Jupsi/logi_z906_wifi/README.md

# Logitech Z906 WiFi Home Assistant Mod with Console Integration

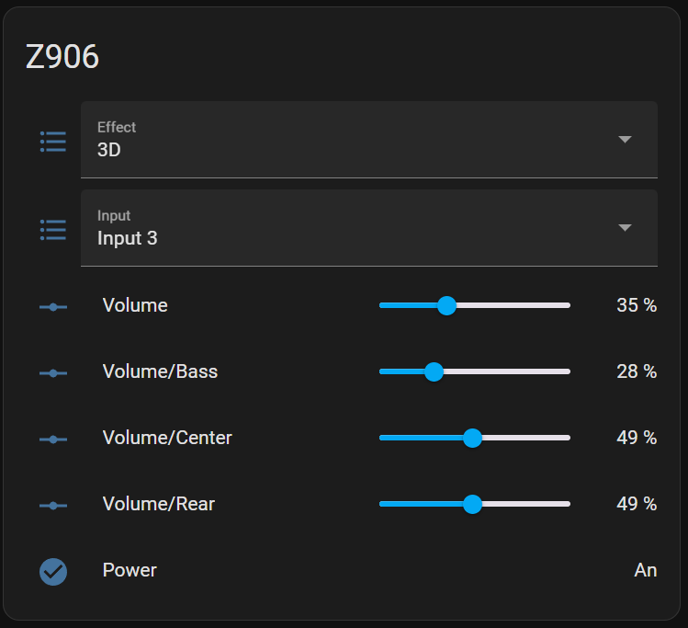
[picture p1: images/haos.png]
Z906 WiFi Mod


This project provides a way to control your Logitech Z906 speaker system via WiFi using an ESP32 microcontroller. It includes MQTT integration for seamless control and automatic integration with Home Assistant.

I am aware that there are already multiple projects for this Sound System, but none of them integrated the original Z906 Console.
With this Project you can still use your Console for the System.

This project is perfect for everybody who's IR Receiver stopped working (like mine).

## Features

- Control volume, input, effects, and individual levels of the Z906 system
- Visual Power on/off the Z906 system (Sensor)
- Home Assistant integration using MQTT and auto-discovery
- Keep the Z906 Console functional instead of replacing it
- Visual Feedback for all MQTT-Commands on the Console

## Hardware Requirements

- ESP32 microcontroller
- Logitech Z906 speaker system
- WiFi network
- DE-15 (VGA) Female Breakout Board
- DE-15 (VGA) Male Breakout Board
- (Optional) ESP32 Breakout Board

## Software Requirements

- Arduino IDE
- ESP32 board support for Arduino IDE
- Home Assistant
- Mosquitto MQTT broker

## Installation

1. **Clone this repository:**
   ```sh
   git clone https://github.com/Jupsi/logi_z906_wifi.git
   cd logi_z906_wifi/sketch_jun7a
   ```
2. **Install the necessary libraries in the Arduino IDE:**
   - PubSubClient
   - ArduinoJson

3. **Open the project in Arduino IDE:**
   - Open `sketch_jun7a.ino` in Arduino IDE.

4. **Update WiFi and MQTT settings:**
   - In `WifiSetup.cpp`, update your WiFi credentials.
   - In `sketch_jun7a.ino`, update your MQTT broker credentials in the setup method.

5. **Flash the ESP32:**
   - Connect your ESP32 to the computer.
   - Select the correct board and port in the Arduino IDE.
   - Click "Upload" to flash the ESP32.

6. **Configure Home Assistant:**
   - Ensure Mosquitto broker is installed and running in Home Assistant.
   - The auto-discovery feature should automatically add the Z906 entities to Home Assistant.

## Cable Connections

Below is a table showing all cable connections between the Console, Amplifier, and ESP32:

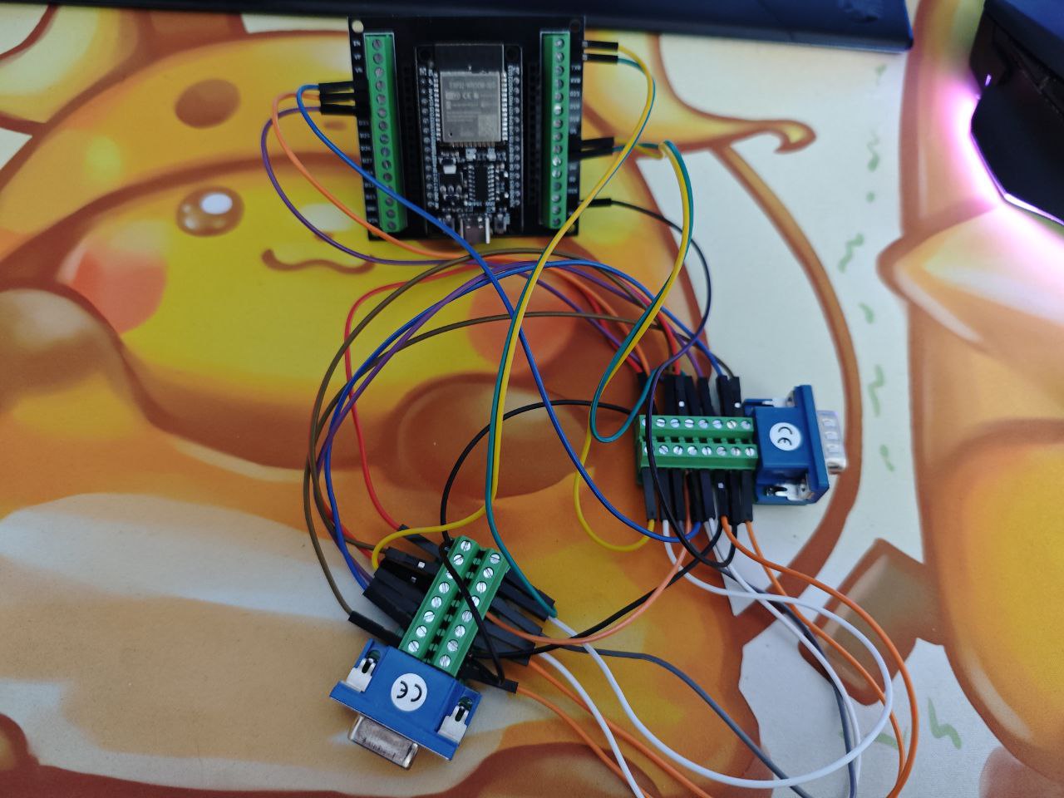
[picture p2: images/alle.jpg]
Cable Connections

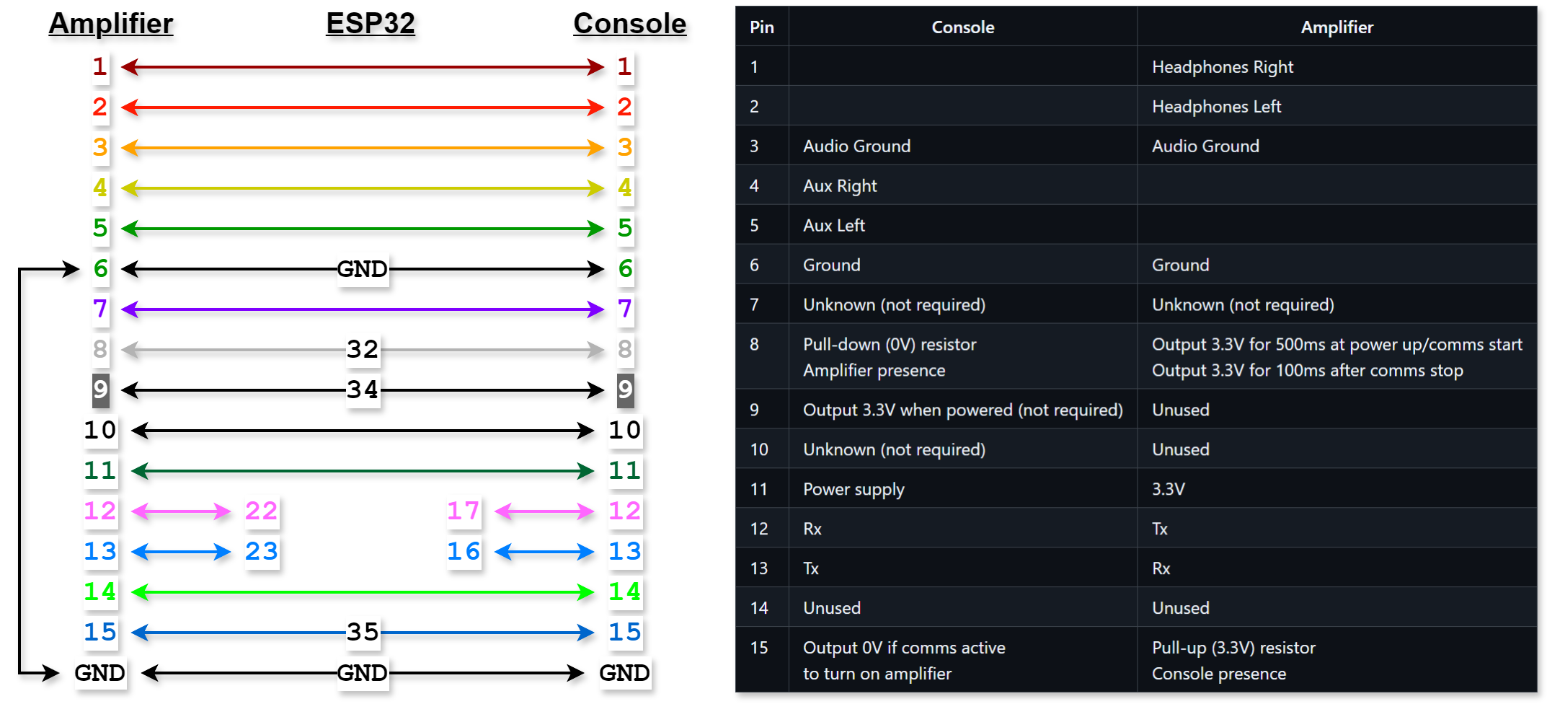
[picture p3: images/diagram.png]
Diagram


| Amplifier | Console | ESP32  |
|---|---|---|
| 1 | 1 | X |
| 2 | 2 | X |
| 3 | 3 | X |
| 4 | 4 | X |
| 5 | 5 | X |
| 6 + GND | 6 | GND |
| 7 | 7 | X |
| 8 | 8 | 32 |
| 9 | 9 | 34 |
| 10 | 10 | X |
| 11 | 11 | X |
| X | 12 | 17 |
| X | 13 | 16 |
| 12 | X | 22 |
| 13 | X | 23 |
| 14 | 14 | X |
| 15 | 15 | 35 |
| GND | GND | GND |

You can adjust all ESP32 Headers in the z906.h file.
```
//esp GPIO Header
  const int ADC_PIN_LOW = 35;
  const int ADC_PIN_CON_BOOT = 32;
  const int ADC_PIN_CABLE_CONNECTED = 34;
  const int8_t RX_CONSOLE_GPIO = 16;
  const int8_t TX_CONSOLE_GPIO = 17;
  const int8_t RX_AMP_GPIO = 22;
  const int8_t TX_AMP_GPIO = 23;
```

## Known Issues
- When restarting the console with the dedicated power button some garbage data will arrive on the serial lines. This confuses the console and you'll have to un- and replug it. I tried to fix that by integrated Pin 15 and Pin 8 but its not working properly.
- Mute is mostly tracked by the console so I could not integrate it into Home Assistant and provide full functionality.

## Troubleshooting
- Console is switching Inputs and/or Effect on its own
    1. Switch the Console off with the dedicated Power button.
    2. Wait atleast 5 seconds to assure the Console shuts down completely.
    3. Press Input for 8 Seconds and wait for 4 Input lights to light up.
    4. Console config is reset to default.
    5. Sometimes this needs to be done without the ESP32 in place.

- Console won't start
    1. Unplug the Console from ESP32.
    2. Restart ESP32.
    3. Wait ~10 seconds for ESP32 to startet completely.
    4. Replug the Console.

- Console auto shuts off
    1. Turn on the Console.
    2. Press Level for 5 Seconds until the Level lights shut off.
 
- Console shows 3 LEDs (no Serial Signal)
     1. Plug off Console
     2. Restart ESP
     3. Wait for ESP to fully Boot
     4. Plug in Console
 
None of the above problems appear when auto shutdown is turned off and the console is powered off while connecting everything together.

All of the problems are due to the Fact I could not figure out how to correctly use Pin 8 and Pin 15 since there is no real documentation about them. 
Maybe someone will figure it out.

## License
This project is licensed under the GNU General Public License v3.0 (GPL-3.0). You are free to use, modify, and distribute the code, provided it is not for commercial purposes.

## Contribution
Contributions are welcome! Please open an issue or submit a pull request if you have any improvements or bug fixes.

## Support
For any questions or support, please open an issue in this repository.

## Special Thanks
- https://github.com/nomis for reverse Engineering this System
