Jupsi/logi_z906_wifi/images/connectors.jpg

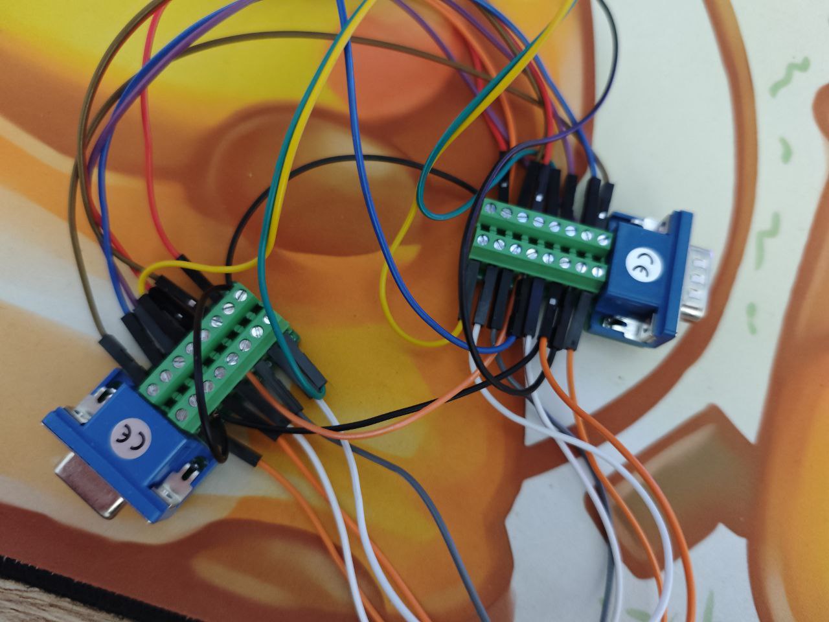
images/connectors.jpg
