Jupsi/logi_z906_wifi/images/daisychain.jpg

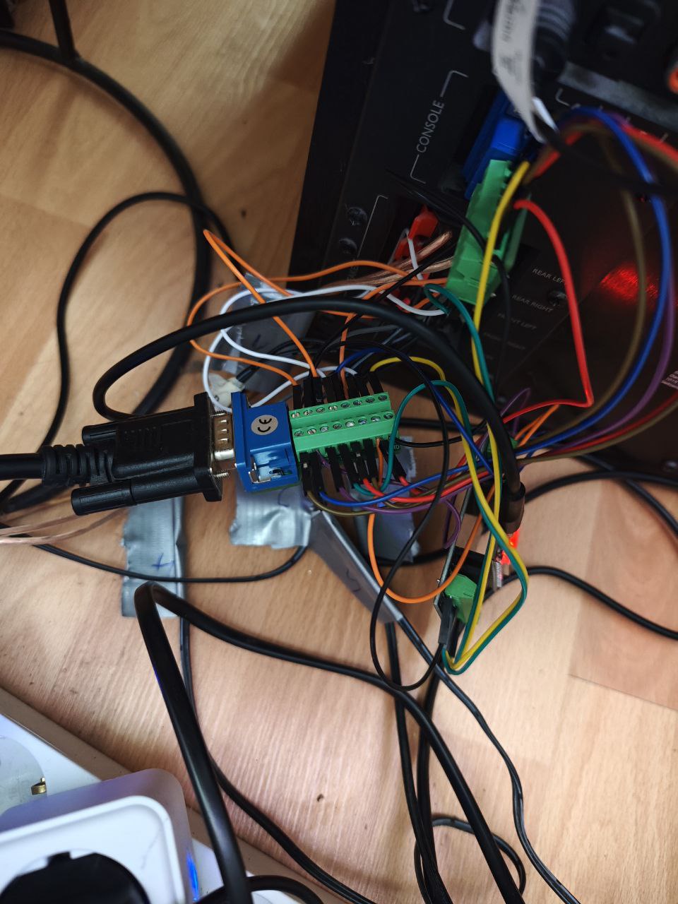
images/daisychain.jpg
