Jupsi/logi_z906_wifi/images/esp.jpg

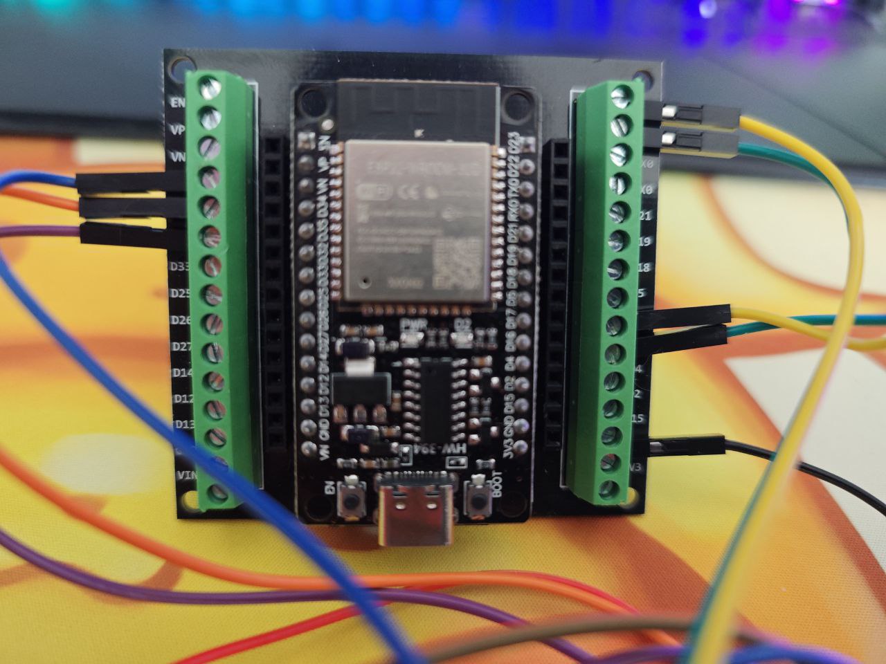
images/esp.jpg
