Jupsi/logi_z906_wifi/images/kabel.png

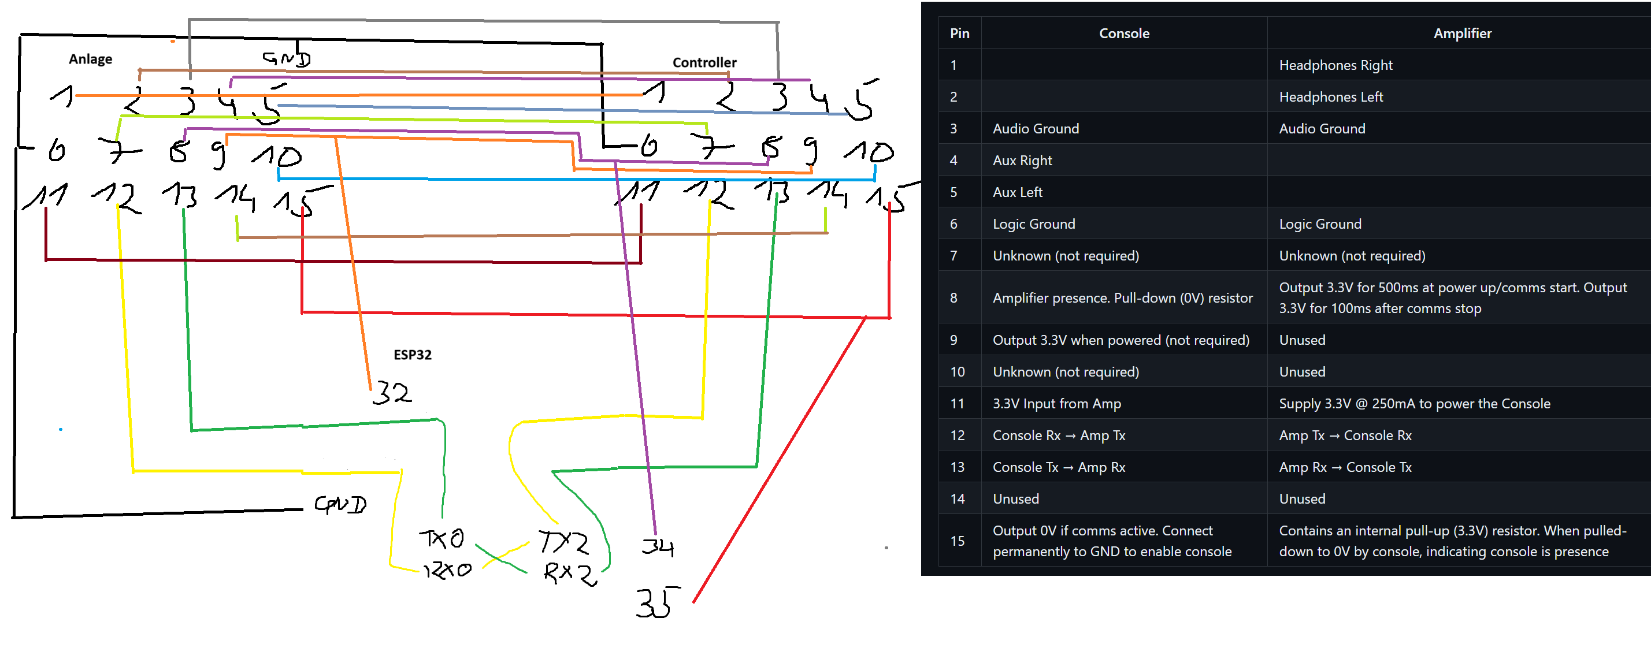
images/kabel.png
