Jupsi/logi_z906_wifi/(threads)

Thread 1 (2024-08-09):

An Other Build ?

anhnvme, 2024-08-09:
Hello,
Fist all, thank you for creating this project

I see this guy and his project look like simple https://github.com/LewisSmallwood/IoT-Logitech-Z906
Just once  Male DE-15 instead 2 cable like you

I think you can look into this project then convert to MQTT ?

Jupsi, 2024-08-10:
Hi, my Project was specially ment to be 2 Cables because i wanted to intergrate the z906 Console.

I do not understand what issue you want to report with this.
Kind regards

Closed 2024-08-27.

Thread 3 (2024-09-13):

Rear Volume controls work for volume down, but not volume up

EpicLPer, 2024-09-13:
Heya,

I think there's a bug (or at least on my Z906) where adjusting the rear speaker volume down in Home Assistant works just fine, as example setting it from 100% to 60% works as expected.
However trying to set the volume back up results in the volume stepping down further, as example adjusting back from 60% to 100% results in the Z906 setting the rear speakers to 21% for whatever reason :) Trying to set them again to 100% just turns it to 0% entirely then.

When adjusting the volume back to 100% via the remote updates the value on Home Assistant as normal again.

Might be a bug where the volume up serial communication was accidentally flipped around and it's sending a volume down command instead?

Thanks already for your work here, I've been waiting for years for someone to realize a project like this! ❤️

Jupsi, 2024-09-13:
Yes the bug is known and i will fix it as soon i have spare time.
For a quick self fix
go to z906_onmqttmessage.cpp
and adjust the code like this
void Z906::_OnMQTTMessage_SetVolume_Rear(MQTT* mqttClient, const char* message) {
  //Rear Volume Broker Message Handle
  auto volume = Z906::_Helper_ConvertPercentToVolume(atoi(message));

  if (volume > _volume_rear) {
    while (volume > _volume_rear) {
      volume--;
      serialAmp->write(static_cast<uint8_t>(SERIAL_HEADER::RESET_IDLE_TIME));
      serialAmp->write(static_cast<uint8_t>(SERIAL_HEADER::VOLUME_REAR_UP));
      serialAmp->write(static_cast<uint8_t>(SERIAL_HEADER::RESET_IDLE_TIME));
    }
  } else {
    while (volume < _volume_rear) {
      volume++;
      serialAmp->write(static_cast<uint8_t>(SERIAL_HEADER::RESET_IDLE_TIME));
      serialAmp->write(static_cast<uint8_t>(SERIAL_HEADER::VOLUME_REAR_DOWN));
      serialAmp->write(static_cast<uint8_t>(SERIAL_HEADER::RESET_IDLE_TIME));
    }
  }
  Serial.print("Rear Volume Set to: ");
  Serial.println(volume);
}

EpicLPer, 2024-09-13:
Thanks, will try!

Bit offtopic but do you by any chance plan to port this to ESPHome as an official integration at some point? Might also be easier for firmware updates or trying to debug the communication over WiFi directly, might make debugging and testing things for the unused Pins easier too :)

I also plan to design and provide a 3D printed enclosure for this project when I have some time, I used a cut extension cord instead of breakout connectors in my case.

Thanks again for the project and the quick reply!

Jupsi, 2024-09-13:
Im currently busy in my private life. My next plan for this project was to get a oscilloscop and fix the garbage data at console startup.

I've never looked into ESPHome or how to make an official integration as this is my very first esp project. I dont like the thought integration something that isnt 100% working so maybe when i sorted that electircal issue out.

I also thought about to make a 3d enclosure but as i finished the V1 of this i had no time todo so yet. Thats also why my pictures are more like PoC and not beatiful ;)

And developing this with a breakout board was much easier to flip cables around that. Contribution to make this prettier are welcome if you want to add some value to this project.

Kind regards

EpicLPer, 2024-09-13:
Course I'll try my best to contribute :) I've been waiting for like 2+ years for someone to do a project like this, searching every few months for it. When I saw this one I instantly jumped on it lol, already loving it 👀

Closed 2024-09-15.

Thread 4 (2024-11-11):

Problem getting this to work

frostworx, 2024-11-11:
Hello,
foremost, thank you very much for this great project!

I recently bought a Z906 and shortly after found this cool solution.
Although we double/triple checked the wires, unfortunately we were unable to make it work this weekend.

The esp joins the network as expected and connects to MQTT, which in turn is autodetected by home assistant.
The "Power" state is detected correctly as "Off" but there doesn't seem to be an option to turn it on from Home-Assistant side.

When powering on via console/remote nothing happens at all.
When holding INPUT on the remote for 5 seconds, all input LEDs on the console turn on, so something is happening.

I bought 2 DE-15 (VGA) Female Breakout Board and 2 DE-15 (VGA) Male Breakout Board, so I was able to test [the project IoT-Logitech-Z906](https://github.com/LewisSmallwood/IoT-Logitech-Z906) easily and it works as expected.

I'd love to get your project working, as the MQTT/HA implementation seems perfect, but I'm a bit lost now.
The z906 version returned by the other project is '154', maybe an incompatible firmware?

I would appreciate it if you had some hints on what else we could try.

frostworx, 2024-11-11:
Hey,
thank you for your quick help!

Ah, I see, that explains why there is no power on option :)

I can't turn the device on via console/remote, so I can't test if volume control do work in HA.
Good idea with checking the serial logs, but I will probably need some days before I can test it again.

_(the network and MQTT HA connection might have only worked, while the esp was not attached to the z906, but only via serial on the pc, I apologize for the confusion, I'll need to check that again as well)_

Thanks a lot again for your help!

Jupsi, 2024-11-11:
try connecting the Console to Amp without the esp, reset the config (keep the system in power mode) unplug console and daisychain esp and check if it then works.

I had this issue you describing while developing and it did cost me a couple of days to figure out why it didnt want to power on.

frostworx, 2024-11-11:
Thank you very much!
I'll check that shortly (tomorrow?) and will report back.

frostworx, 2024-11-12:
I reset the config using vanilla console with remote 8 seconds input button press, left the amp powered on & daisychained the esp (connected to pc using moserial with baud 57600):

- the esp ins pingable and connects to mqtt
-  when moving the sliders in HA I see random binary garbage in the serial console, so unfortunately no usable logs for now (also tried other baudrates, maybe the whole problem is simply a broken cable?)
- the console leds remain off, no matter which button I press, pressing the power button produces a sound in the speakers
- the Power status in HA doesn't change and remains Off, every slider state remains "unknown"

_(is the vanilla console supposed to have leds enabled after un- and replugging it standalone? They are all off here, so it is unclear if the am still is powered on after adding the esp)_

Jupsi, 2024-11-15:
sorry for the late reply.
can you post how the USB Serial Output looks like?

frostworx, 2024-11-18:
sorry for the lag as well.

I'll try to find the time for another run soonish to get the serial out
_(iirc it was some "garbage" separated by pipes if that helps)_

it is no big deal for me btw. for now, I simply send IR remote codes with my it blaster to HA, which works for the very basic controls I need
_(of course having a back channel to home assistant would be better)_  :)

frostworx, 2024-11-22:
sorry, didn't have much time.
when pressing several controls via mqtt/HA I get this broken output:

`
`~pp|`pp|
pp|pp|
p`|p
`~pp|`pp|
pp|pp|
p`|p
`~pp|`pp|
pp|pp|
p`|p
`~pp|`pp|
pp|pp|
p`|p
`~pp|`pp|
pp|pp|
p`|p
`~pp|`pp|
pp|pp|
p`|p
`~pp|`pp|
pp|pp|
p`|p
`~pp|`pp|
pp|pp|
p`|p
`~pp|`pp|
pp|pp|
p`|p
`~pp|`pp|
pp|pp|
p`|p
`~pp|`pp|
pp|pp|
p`|p
`~pp|`pp|
`

Probably won't help that much :D

I think it would be a better approach to restart from scratch with more time, so your limited time is not wasted with this issue. Likely I have a broken cable or similar.

Thank you for trying to help me and have a nice weekend!

Jupsi, 2024-11-22:
probably something is off with your broker settings, the HA message should not lead to trash data

frostworx, 2024-11-22:
nah, all (multiple) mqtt devices work just fine.

I'll restart from scratch with new cables and a new esp (just in case) in winter(?) :)

thanks a lot for your project and help!

Jupsi, 2024-11-22:
which HA Method you try with your Log previous? Mute or Unmute will produce alot of data so just try to increase or decrease anyvolume by 1% to remove overhead log
Also does your usb serial report any English log like "Volume Set to" or something?

frostworx, 2024-11-23:
I tried all volume sliders and effect/input dropdowns.
No, there wasn't any human readable string in the output.
please don't worry, I'm pretty sure it is a hardware problem on my side.

frostworx, 2024-12-01:
I found out that a "esp32 wroom 32" batch I once bought seems to be faulty.
when testing a different project with one of those (micro usb) esps the serial console was garbage as well.
swapping the esp with a different "esp32 wroom 32" (with usb-c) fixes the broken serial console for both projects.

The commands sent from HA are shown correctly in the serial console now,
but controlling via console/ir remote doesn't do anything (only some crackling in the speakers, leds remain off).

 We'll retry with fresh cables (soonish) as this seems to be a wiring issue.

EpicLPer, 2024-12-01:
@frostworx I had this loud pop/crackling issue when the amp couldn't talk to the console properly, so it might try to send a sort of hard reset command to the amp without first muting the output resulting in that pop? Not sure.
But yeah, it might be an issue with your wiring and the console not being routed through to the amp directly.

Jupsi, 2024-12-01:
Thats nice to hear.
If the Console doesnt response reset the Console with no ESP inbetween

I hope i can fix that by next year i know this is annoying.

frostworx, 2024-12-01:
Thank you both for your help @EpicLPer and @Jupsi! Very appreciated :)

The explanation with the hard reset attempt sounds reasonable.
When the new cables don't help, I'll try the console reset again for sure.

LucianTothezan, 2024-12-06:
i am following closely the developpement You  guys are doing. I am very interrested in this project to be able to implement it myself.

LucianTothezan, 2024-12-08:
Hello all. I have successfully daisy chained the esp32 board with the z906 and I must say it works flawlessly. I am now able to both control the system from the IR remote and from HA, via a broadlink r3mini remote. I am actually using the information related to the status of the system (on, off,  values for volumes, etc) and I have created a dashboard on a tablet that emulates the physical remote of both tv and z906. The status of the z906 is taken from your binary sensor for that, and based on that status I use an automation to turn the system on or off together with the tv. Very happy with this layout. Thank You again for this project.
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

frostworx, 2024-12-08:
congratulations @LucianTothezan

I haven't touched the project again yet, but apparently my problem is on my hardware side, so I guess this issue is invalid.

thank you all for trying to help!

LucianTothezan, 2024-12-08:
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

It is a silly question but ... Did You check if the connectors are not considered in reverse in regards to the wiring given in the project: male as subwoofer , female as console?

frostworx, 2024-12-08:
>
> It is a silly question but ... Did You check if the connectors are not considered in reverse in regards to the wiring given in the project: male as subwoofer , female as console?

Yeah, I did indeed, but thank you for trying to help :)

No big deal really, I'm sure it'll work on the next fresh try.

until then the broadlink blaster will be enough

Jupsi, 2024-12-14:
I just hooked mine up to my PC because i had to update my MQTT Settings and did some research.
 Have you set your Serial Baud Rate to 115200 on Arduino IDE ?

Also my Garbage Data Problem seem to be gone for whatever reason. I can restart my Console without any issues..

frostworx, 2024-12-16:
sorry for the delay. unfortunately I did not have the chance to look into this again yet, but yeah, I tried several baud rates, so likely also 115200.
again thank you very much for all your help here! you should not really worry though, I'm sure I can get it to work :)

Closed 2024-12-08.

Thread 5 (2024-11-22):

ESP8266 compatibility

LucianTothezan, 2024-11-22:
Hello. is this project capable of running on ESP8266 or the hardware is not powerful enough? Thank You in advance for Your feedback. Best regards.

Jupsi, 2024-11-22:
Hi, i can't answer this question since i never owned a ESP8266.

You need 2 dedicated Serial Ports (4 Pins total)
3 ADC Ports (3+1 Pins total)

CPU wise i cant say if an ESP8266 is capable of running this but i would assume it can. Nevertheless i cant help if any library isnt compatible with the 8266. Good Luck trying it out :)

LucianTothezan, 2024-11-22:
Thank You for the prompt reply. You gave the answer i believe in terms of compatibility: the ESP8266 has only one ADC pin so if the project needs 3 , there is no way to use the 8266. Best regards.

LucianTothezan, 2024-11-23:
If i may have another question... You are powering the esp32 module from pin8? is that enough for the board in terms of ams once the commes are down? i do not see how...

Jupsi, 2024-11-23:
Hey, no its still powered by USB, Pin 8 is for checking Power on the Logitech System.

And i cant say if parallel hooking is possible on Serial, but with my Setup the Console is showing the correct LED's when switching Volume or Changing Channel / Effect. But its not parallel hooked its more like a daisy chain.

LucianTothezan, 2024-11-23:
Ah, so You have independent power for the board.

Need to search for daisy chain meaning :)

Thank You for taking the time for replying. I am willing to try your project so I ordered some esp32s and the 2 dsub connectors. I have used the Lewis Smallwood version until now but I would very much like to have controls from both the console and HA for the Z906.
Best regards.

Thread 7 (2024-12-17):

ESP power supply

RowCZ, 2024-12-17:
Maybe stupid question but I am not sure, the ESP is powered independently by USB or from 3.3V from pin 11?
If independently, did you try to "steal" power for ESP form 3.3V rail?
Thanks.

Closed 2024-12-18.

Thread 8 (2024-12-20):

Clearly Esp32 board image

anhnvme, 2024-12-20:
Hello.

Could you take a picture esp32 board more clearly ?

anhnvme, 2024-12-20:
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

by the way. could you help me verify if it correct ?
i plug into speaker but console not work. MQTT not show any value.

Jupsi, 2024-12-26:
Hi, the System cant be turned on by Home Assistant since the Power Up is handled by the Console itself. You can set the Z906 to not auto power off.

frostaholic, 2025-01-04:
this may not be of any use but my z906 is connected to my TV and a raspberry pi for volumio music server. volumio is connected to home assistant for music and TTS. before this I had to manually turn the inputs over which was impossible to know when there was going to be a notification through TTS.
Now I can just make an automation to do it for me.
`alias: change logitech input to volumio
description: volumio playing change to input 2
triggers:
  - trigger: state
    entity_id:
      - media_player.volumio
    to: playing
conditions: []
actions:
  - action: select.select_option
    metadata: {}
    data:
      option: Input 2
    target:
      entity_id: select.z906_input
mode: single
`

Closed 2025-01-09.

Thread 9 (2025-01-26):

op[tion for power up device

mrlordziemniak, 2025-01-26:
Hi
in features u wrote: Power on/off the Z906 system
so where is option to power on /off? i see only binary sensor with status of power button

Jupsi, 2025-01-26:
Hi,
i've updated the README.

Power is handled in the Controllers firmware and can't be controlled over Serial Data.
Sorry for the missunderstanding.

Jupsi, 2025-01-26:
When your Controller is auto Powering off you can press the Level Button for 5 Seconds and your Controller will stay powered on over time

Closed 2025-02-20.

Thread 10 (2025-03-03):

Changing volume sometimes not responding

RobbeDR, 2025-03-03:
Great project!
I've got an issue, when i want to change the volume of the Z906, the input i give to turn up to turn down the volume doesn't respond correctly.
Pressing and holding the volume up or down button doesn't change the volume smoothly. It needs a couple of seconds before some volume changes.
Probably because there is a lot of input i give to the device to change a value constantly.
I don't have an issue with the other inputs. The volume is something that i'd like to change smoothly but doesn't do so.
Is there anything that can be done about that?
Thanks.

RobbeDR, 2025-03-03:
Some extra info: the physical volume know responds correctly. Only when i want to change the volume via a remote or via home assistant it doesn't go as smooth as i'd like

RobbeDR, 2025-03-03:
Thanks! works perfectly!

Closed 2025-03-03.

Thread 11 (2025-04-01):

Powering off the Z06

dorian-simion, 2025-04-01:
Hello,

I saw in you reddit post that the powering off is not supported.

But I saw in your repo and in Nomis https://github.com/nomis/logitech-z906 repo that there are some power off constants.

Could you please tell me shortly why these commands do not work?

I thought of trying out my luck with power on/off but wanted to ask you first.

Thank you

Jupsi, 2025-04-05:
Hi,

there is a command for power on /off but thats only for the Amplifier. The Console has its own internal Power State that can't be changed with Serial messages.
When you press the Button on the Console to power it sends the Serial message to the Amp to also power on (instead of idle).

Doesnt work the other way around sadly.

If you dont mind to open your Console you can add 2 wires parallel to the  on Button and control that with the ESP, but i didnt want to risk damaging my Console so i haven't done that. I just set the Auto Power off to disabled like i described in my FAQ.

Kind regards

Closed 2025-04-23.

Thread 13 (2025-05-12):

mqtt connection issue

Tomas911, 2025-05-12:
failed with state -2
Reconnect to MQTT Broker
Attempting to connect MQTT... Domain: homeassistant.local Port: 1883
Auth with User: XXXXXX
Password: XXXXXX
Client ID: esp32-client-5C:01:XX:4D:63:XX

getting this state and its not connecting to mosquitto broker
(credentials blurred for privacy purposes)

Tomas911, 2025-05-13:
i did, just noticed it isnt even connecting to wifi

Jupsi, 2025-05-13:
check your wifisetup.cpp and that you have 2.4ghz wifi. cant help with that really.

Tomas911, 2025-05-13:
i did check all that even looked in my router settings couldnt find anything wrong

Thread 14 (2025-07-15):

power?

gino-terlingen, 2025-07-15:
hey there

is there a way to turn on/off the system form the esp32/home assistant
because in the docs it says only sensor

many thx

Jupsi, 2025-07-23:
Hey,

no there is no way to power off the console without modding it and adding cables to the PCB sadly. the Power Off Command only powers off the amp not the whole system

Closed 2025-08-15.

Thread 15 (2025-08-15):

Use without OEM control panel?

GoTeamScotch, 2025-08-15:
Hello! I don't own the OEM Logitech control panel for my Z-906. I've just been using Docklight to send serial commands from my PC. Does this project require the Logitech control panel to be present in order to work? Can I just rely on Home Assistant to send commands?

Jupsi, 2025-08-15:
@systemofapwne i had this while doing this project. a simple reset of the Console revived it.

@GoTeamScotch as mentioned this project does not work without console since the ESP is daisychained, sniffing the pakets and act as a middleman for mqtt.

Jupsi, 2025-08-15:
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

If you remove the console from the project you can turn the power sensor into a switch because the AMP power can be controlled by ESP. It's the Console that handle Power On on its own and can't be manipulated via ESP.

Thread 17 (2025-09-03):

No serial (3 LEDs)

AkdM, 2025-09-03:
Hey there,

Thanks for the project.

I think I've wired up everything correctly, but I did changed the pins in z906.h as I am using a ESP32S3 WROOM (devkit). Since some pints are not the same, I've changed it like so:

```
const int ADC_PIN_LOW = 4; // was 35;
const int ADC_PIN_CON_BOOT = 5; // was 32;
const int ADC_PIN_CABLE_CONNECTED = 6; // was34;
const int8_t RX_CONSOLE_GPIO = 16;
const int8_t TX_CONSOLE_GPIO = 17;
const int8_t RX_AMP_GPIO = 7; // was22;
const int8_t TX_AMP_GPIO = 15; // was 23;
```

But I am facing the 3 LEDs issue. Can it be because of the used pins? Maybe somewhere I need to use the RX and TX pins of the ESP32?
I've already tried the listed troubleshooting in the README without success.

Thanks!

For clarity, I've unplugged two GND since I'm using very short cables I had.

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

Jupsi, 2025-09-03:
The LED bug is when the Console is not getting the correct answer from the AMP. Check (f.e. with Console Print) the Data you send and receive and check if its good.

For Example each request of the Console should be acknowledged with the same byte from the Amp.

Thats where i would start to see if everything is correct
