Jupsi/logi_z906_wifi/(commit log)

2024-09-12 Update README with new image and fix some spelling
    Updated the Readme file with the improved diagram image and fixed some spelling and grammar errors :)
    Also switched the Amplifier and Console columns around to be on par with the new diagram image.
2024-09-15 Fixxed Wrong MQTT Handle for Rear Speakers
    [z906_onmqttmessage.cpp]
2025-08-16 Fixed _On_Serial_Multibyte_Message to read correct effect for channel when processing multibyte message of the amp
    [z906_serial.cpp]
2026-09-07 Fix: Garbage data on boot confused the console
    [z906.cpp]
2026-10-15 Bound the blocking amplifier read and cap the drain loop
    _Serial_Amplifier_ReadByte_With_Wait() waited forever for a byte that may
    never arrive. Multibyte parsing calls it for continuation bytes, so any
    stray byte framed as a multibyte header hangs the entire sketch. The
    symptom is confusing: the board keeps answering pings, because WiFi runs
    on the other core, while MQTT goes silent permanently and the console
    loses the relay. It now gives up after 500ms, ~60x the wire time of one
    byte at 57600 8O1.
    _Serial_Process_Amplifier() also drained with an uncapped while loop. On
    a line delivering bytes as fast as they are consumed the loop never
    exits and the main loop stops. _Serial_Process_Conso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
2026-10-15 Do not log the MQTT password in clear text
    The broker password was printed on every connection attempt. Connection
    is retried in a loop until WiFi is up, so it appears repeatedly on each
    boot, and anyone reading the serial console - or any captured log - gets
    the credential.
    Prints the length instead, which is still enough to tell an empty or
    truncated password from a correct one.
